timchpi/OpenFSU_Release/README.md

# OpenFSU_Release
 Release repo for OpenFSU
 Fire Sequencing Unit for Custom Electric-Blowback Replicas, as well as standard AEGs with more spacious battery compartments.
