timchpi/OpenFSU_Release/Hardware/OpenEFCS_electronics/OpenEFCS_electronics.kicad_pcb

## KiCad design Hardware/OpenEFCS_electronics/OpenEFCS_electronics.kicad_pcb (2022-09-13, last stored version)

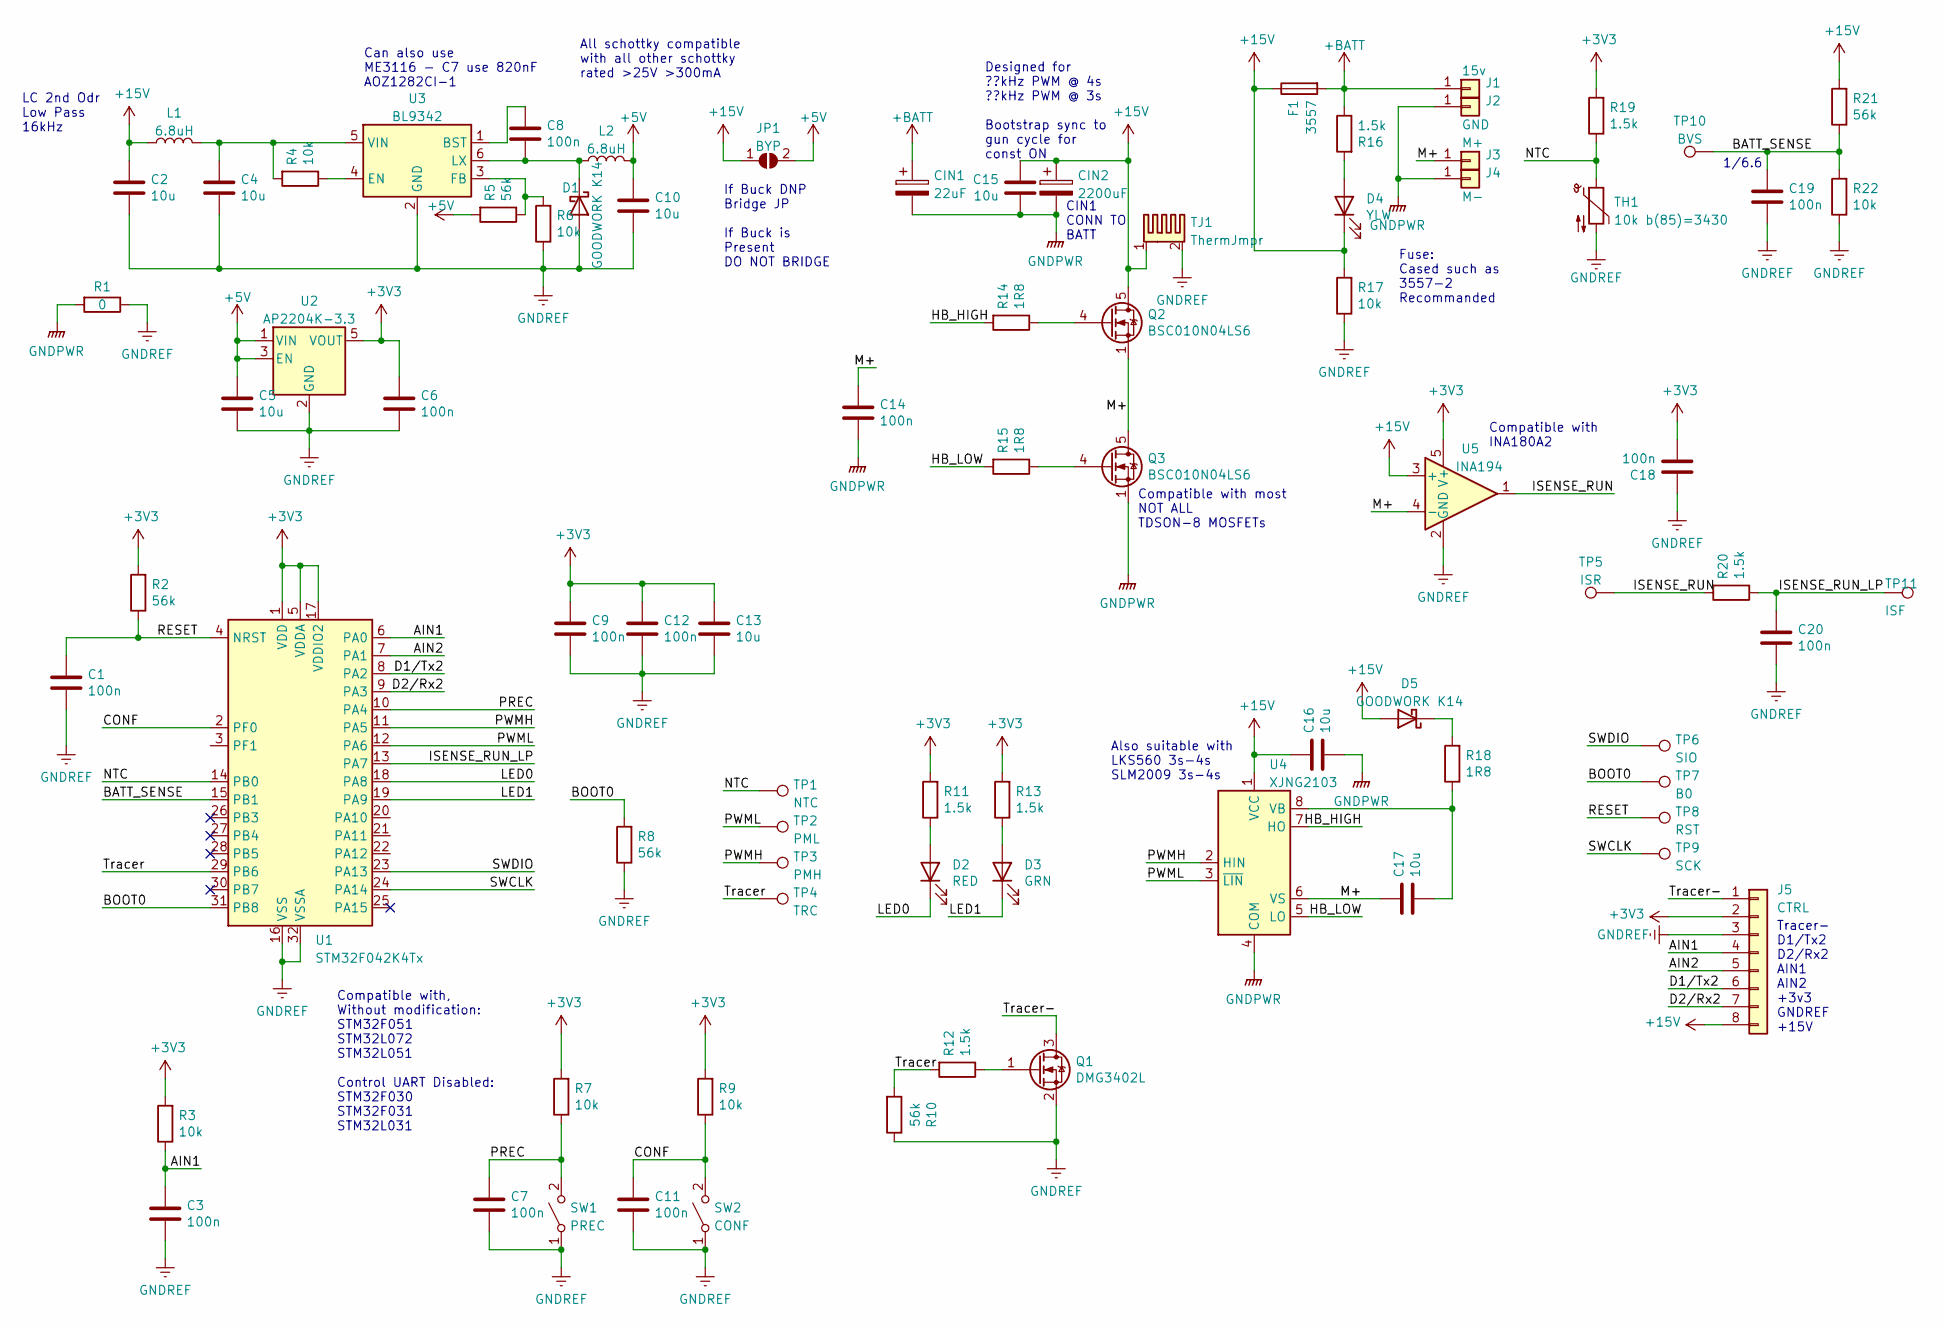
[picture p1: schematic OpenEFCS_electronics.kicad_sch, OpenEFCS Electronics v0.4]

Parts:
C1, C3, C6, C7, C8, C9, C11, C12, C14, C18, C19, C20: 100n; C_0603_1608Metric
C2, C4, C5, C10, C13, C15, C16, C17: 10u; C_0805_2012Metric
CIN1: 22uF; CP_EIA-3528-12_Kemet-T
CIN2: 2200uF
D1, D5: GOODWORK K14; D_SOD-123
D2: RED; LED_0603_1608Metric
D3: GRN; LED_0603_1608Metric
D4: YLW; LED_0603_1608Metric
F1: 3557; Keystone 3557
J1: 15v; SolderWirePad_1x01_SMD_1x2mm
J2: GND; SolderWirePad_1x01_SMD_1x2mm
J3: M+; SolderWirePad_1x01_SMD_1x2mm
J4: M-; SolderWirePad_1x01_SMD_1x2mm
J5: CTRL; JST_PH_B8B-PH-K_1x08_P2.00mm_Vertical
JP1: BYP; SolderJumper-2_P1.3mm_Open_TrianglePad1.0x1.5mm
L1, L2: 6.8uH; L_0805_2012Metric
Q1: DMG3402L; SOT-23
Q2, Q3: BSC010N04LS6; TDSON-8-1
R1: 0; R_0603_1608Metric
R2, R5, R8, R10, R21: 56k; R_0603_1608Metric
R3, R4, R6, R7, R9, R17, R22: 10k; R_0603_1608Metric
R11, R12, R13, R16, R19, R20: 1.5k; R_0603_1608Metric
R14, R15, R18: 1R8; R_0603_1608Metric
SW1: PREC; SW_SPST_B3U-1000P
SW2: CONF; SW_SPST_B3U-1000P
TH1: 10k b(85)=3430; R_0603_1608Metric
TJ1: ThermJmpr; R_1206_3216Metric
TP1: NTC; TestPoint_Pad_1.0x1.0mm
TP2: PML; TestPoint_Pad_1.0x1.0mm
TP3: PMH; TestPoint_Pad_1.0x1.0mm
TP4: TRC; TestPoint_Pad_1.0x1.0mm
TP5: ISR; TestPoint_Pad_1.0x1.0mm
TP6: SIO; TestPoint_Pad_1.0x1.0mm
TP7: B0; TestPoint_Pad_1.0x1.0mm
TP8: RST; TestPoint_Pad_1.0x1.0mm
TP9: SCK; TestPoint_Pad_1.0x1.0mm
TP10: BVS; TestPoint_Pad_1.0x1.0mm
TP11: ISF; TestPoint_Pad_1.0x1.0mm
U1: STM32F042K4Tx; LQFP-32_7x7mm_P0.8mm
U2: AP2204K-3.3; SOT-23-5
U3: BL9342; SOT-23-6
U4: XJNG2103; SOIC-8_3.9x4.9mm_P1.27mm
U5: INA194; SOT-23-5

Connections:
+3V3: C6.1, C9.1, C12.1, C13.1, C18.2, J5.2, R2.2, R3.2, R7.2, R9.2, R11.2, R13.2, R19.2, U1.1 (VDD), U1.5 (VDDA), U1.17 (VDDIO2), U2.5 (VOUT), U5.5 (V+)
+5V: C5.1, C10.1, JP1.2 (B), L2.2, R5.2, U2.1 (VIN), U2.3 (EN)
+15V: C2.1, C15.1, C16.1, CIN2.1, D4.1 (K), D5.2 (A), F1.1, J5.8, JP1.1 (A), L1.1, Q2.5 (D), R17.2, R21.2, TJ1.1, U4.1 (VCC), U5.3 (+)
+BATT: CIN1.1, F1.2, J1.1, R16.1
/AIN1: C3.1, J5.4, R3.1, U1.6 (PA0)
/AIN2: J5.5, U1.7 (PA1)
/BATT_SENSE: C19.1, R21.1, R22.2, TP10.1, U1.15 (PB1)
/BOOT0: R8.2, TP7.1, U1.31 (PB8)
/CONF: C11.1, R9.1, SW2.2 (B), U1.2 (PF0)
/D1/Tx2: J5.6, U1.8 (PA2)
/D2/Rx2: J5.7, U1.9 (PA3)
/HB_HIGH: R14.2, U4.7 (HO)
/HB_LOW: R15.2, U4.5 (LO)
/ISENSE_RUN: R20.2, TP5.1, U5.1
/ISENSE_RUN_LP: C20.1, R20.1, TP11.1, U1.13 (PA7)
/LED0: D2.1 (K), U1.18 (PA8)
/LED1: D3.1 (K), U1.19 (PA9)
/M+: C14.1, C17.1, J3.1, Q2.1 (S), Q2.2 (S), Q2.3 (S), Q3.5 (D), U4.6 (VS), U5.4 (-)
/NTC: R19.1, TH1.1, TP1.1, U1.14 (PB0)
/PREC: C7.1, R7.1, SW1.2 (B), U1.10 (PA4)
/PWMH: TP3.1, U1.11 (PA5), U4.2 (HIN)
/PWML: TP2.1, U1.12 (PA6), U4.3 (~LIN)
/RESET: C1.1, R2.1, TP8.1, U1.4 (NRST)
/SWCLK: TP9.1, U1.24 (PA14)
/SWDIO: TP6.1, U1.23 (PA13)
/Tracer: R10.2, R12.2, TP4.1, U1.29 (PB6)
/Tracer-: J5.1, Q1.3 (D)
GNDPWR: C14.2, C15.2, C16.2, CIN1.2, CIN2.2, J2.1, J4.1, Q3.1 (S), Q3.2 (S), Q3.3 (S), R1.2, U4.4 (COM)
GNDREF: C1.2, C2.2, C3.2, C4.2, C5.2, C6.2, C7.2, C9.2, C10.2, C11.2, C12.2, C13.2, C18.1, C19.2, C20.2, D1.2 (A), J5.3, Q1.2 (S), R1.1, R6.1, R8.1, R10.1, R17.1, R22.1, SW1.1 (A), SW2.1 (A), TH1.2, TJ1.2, U1.16 (VSS), U1.32 (VSSA), U2.2 (GND), U3.2 (GND), U5.2 (GND)
unnamed: C4.1, L1.2, R4.2, U3.5 (VIN)
unnamed: C8.1, U3.1 (BST)
unnamed: C8.2, D1.1 (K), L2.1, U3.6 (LX)
unnamed: C17.2, R18.1, U4.8 (VB)
unnamed: D2.2 (A), R11.1
unnamed: D3.2 (A), R13.1
unnamed: D4.2 (A), R16.2
unnamed: D5.1 (K), R18.2
unnamed: Q1.1 (G), R12.1
unnamed: Q2.4 (G), R14.1
unnamed: Q3.4 (G), R15.1
unnamed: R4.1, U3.4 (EN)
unnamed: R5.1, R6.2, U3.3 (FB)

Notes on the sheet:
Tracer- D1/Tx2 D2/Rx2 AIN1 AIN2 +3v3 GNDREF +15V
1/6.6
All schottky compatible with all other schottky rated >25V >300mA
If Buck DNP Bridge JP If Buck is Present DO NOT BRIDGE
Can also use ME3116 - C7 use 820nF AOZ1282CI-1
Fuse: Cased such as 3557-2 Recommanded
Designed for ??kHz PWM @ 4s ??kHz PWM @ 3s Bootstrap sync to gun cycle for const ON
Compatible with most NOT ALL TDSON-8 MOSFETs
Compatible with INA180A2
Also suitable with LKS560 3s-4s SLM2009 3s-4s
LC 2nd Odr Low Pass 16kHz
CIN1 CONN TO BATT
Compatible with, Without modification: STM32F051 STM32L072 STM32L051 Control UART Disabled: STM32F030 STM32F031 STM32L031

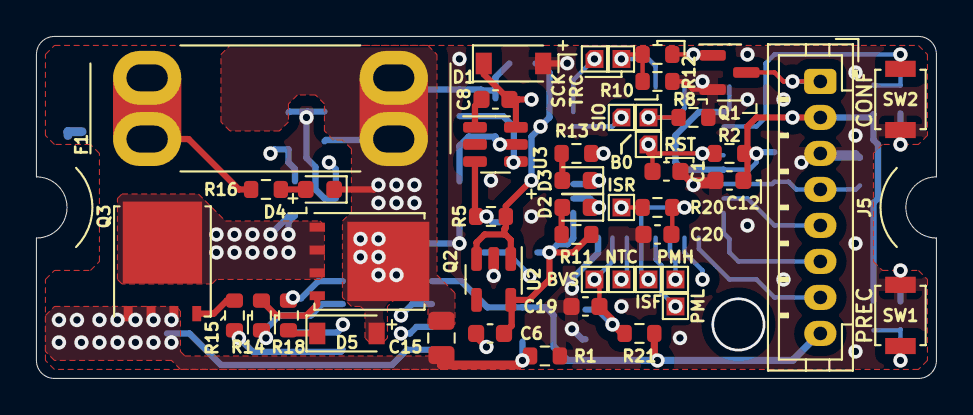
[picture p2: board OpenEFCS_electronics.kicad_pcb from above]

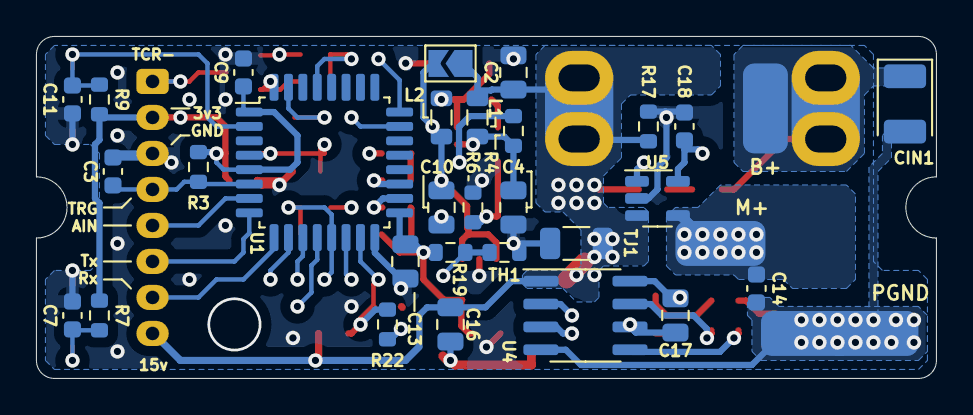
[picture p3: board OpenEFCS_electronics.kicad_pcb from below]

Board: 4 copper layers, 50.0 x 19.0 mm, 79 parts (33 on the bottom side), 42 nets.
