timchpi/OpenFSU_Release/(commit log)

2022-06-23 Updated minor BOM mistake
    [OpenEFCS_electronics.kicad_pcb, OpenEFCS_electronics.kicad_sch]
2022-06-29 Release v0.3.1
    Corrected footprint for INA2180
    Regenerated manufacturing files
    [OpenEFCS_electronics-B_Cu.gbl, OpenEFCS_electronics-B_Mask.gbs, OpenEFCS_electronics-B_Paste.gbp, OpenEFCS_electronics-B_Silkscreen.gbo, OpenEFCS_electronics-Edge_Cuts.gm1, OpenEFCS_electronics-F_Cu.gtl, OpenEFCS_electronics-F_Mask.gts, OpenEFCS_electronics-F_Paste.gtp]
2022-09-13 design complete for second prototype
    [OpenEFCS_electronics-B_Cu.gbl, OpenEFCS_electronics-B_Mask.gbs, OpenEFCS_electronics-B_Paste.gbp, OpenEFCS_electronics-B_Silkscreen.gbo, OpenEFCS_electronics-Edge_Cuts.gm1, OpenEFCS_electronics-F_Cu.gtl, OpenEFCS_electronics-F_Mask.gts, OpenEFCS_electronics-F_Paste.gtp]
2023-05-27 Removed current design
    Need ESD protection and transient spike protection.
    Will release updated design.
    [OpenEFCS_electronics-B_Cu.gbl, OpenEFCS_electronics-B_Mask.gbs, OpenEFCS_electronics-B_Paste.gbp, OpenEFCS_electronics-B_Silkscreen.gbo, OpenEFCS_electronics-Edge_Cuts.gm1, OpenEFCS_electronics-F_Cu.gtl, OpenEFCS_electronics-F_Mask.gts, OpenEFCS_electronics-F_Paste.gtp]
